NMBU-BuildingPhysics/SpatialSpectralMonitoring/04_Documentation/README.md

# Documentation

This folder contains project images and figures used in the main README and associated publication. Component-specific documentation is located alongside the code in each sub-folder.

## Images

| File | Description |
|---|---|
| `images/graphical_abstract.png` | Graphical abstract for the associated journal article |
| `images/Summary_image.png` | Conceptual overview of the sensing system capabilities |
| `images/NMBU_Logo_English_RGB.png` | NMBU institutional logo |

## Project Documentation

| Resource | Description |
|---|---|
| [Hardware Documentation](../01_Hardware/) | 3D models, PCB designs, and fabrication files |
| [Firmware Documentation](../02_Firmware/) | ESP32 code, utilities, and programming guides |
| [Python Suite Documentation](../03_Python_Suite/) | Analysis tools, calibration scripts, and validation |

## Contributing

Help improve this documentation by:

1. **Reporting Issues** - Found something unclear? Open an issue on GitHub
2. **Suggesting Improvements** - Have ideas for better organization or content?
3. **Contributing Content** - Write guides, fix typos, or add examples
