NMBU-BuildingPhysics/SpatialSpectralMonitoring/01_Hardware/PCB/Image_PCB.png

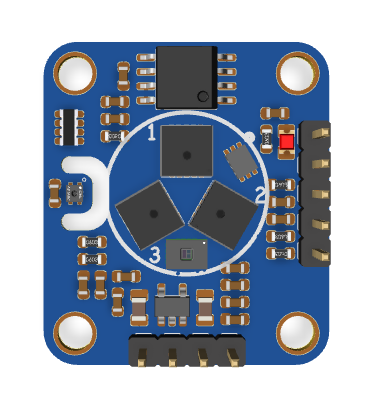
01_Hardware/PCB/Image_PCB.png
