NMBU-BuildingPhysics/SpatialSpectralMonitoring/03_Python_Suite/02_Absolute_Calibration/02_Spectral_Calibration/x1_Analysis_Plots/x1_spectral_sensor_response.png

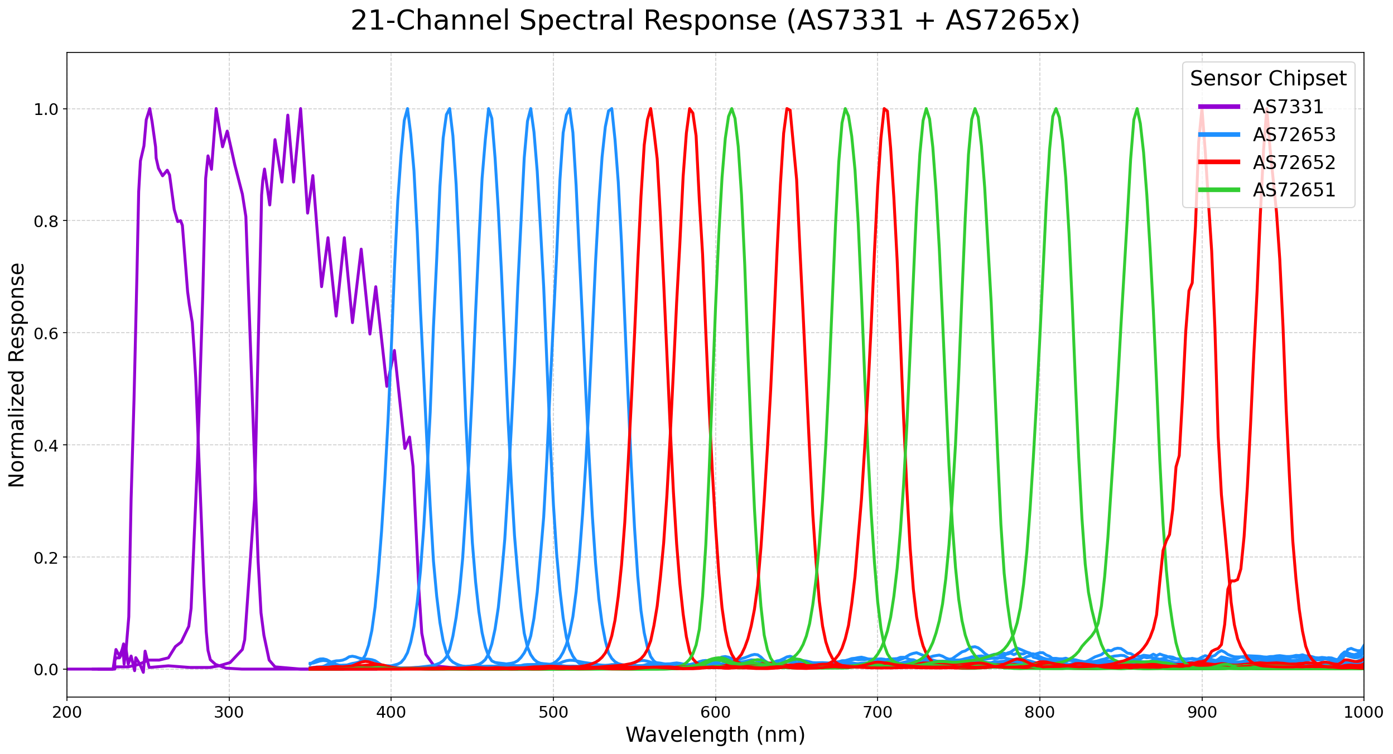
03_Python_Suite/02_Absolute_Calibration/02_Spectral_Calibration/x1_Analysis_Plots/x1_spectral_sensor_response.png
