NMBU-BuildingPhysics/SpatialSpectralMonitoring/01_Hardware/3d_Models/Source_Enclosure_Design.step

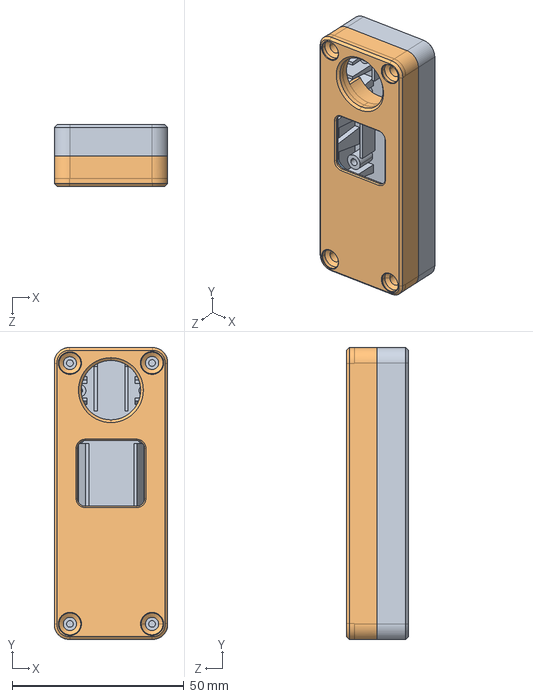
[picture p9: CAD file, 2026-10-23]
01_Hardware/3d_Models/Source_Enclosure_Design.step
33.0 x 85.0 x 18.0 mm
