NMBU-BuildingPhysics/SpatialSpectralMonitoring/01_Hardware/3d_Models/Enclosure_Print_Ready.stl

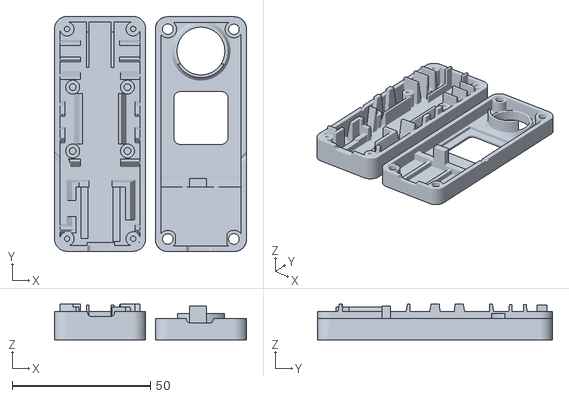
[picture p10: CAD file, 2026-02-18]
01_Hardware/3d_Models/Enclosure_Print_Ready.stl
69.5 x 85.1 x 12.9
