NMBU-BuildingPhysics/SpatialSpectralMonitoring/01_Hardware/3d_Models/Enclosure_Lid.stl

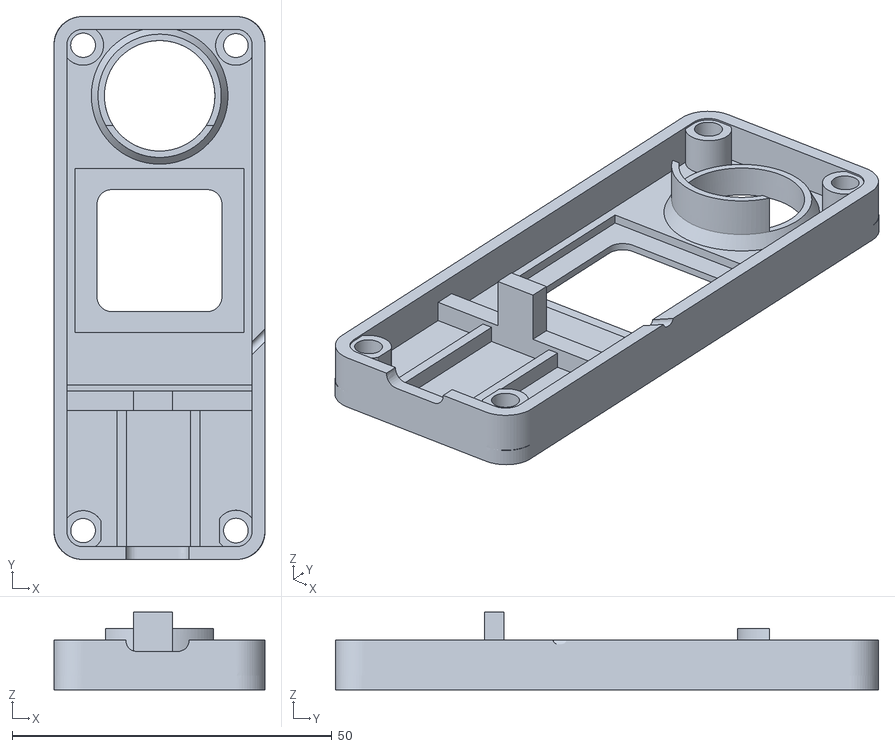
[picture p11: CAD file, 2026-02-18]
01_Hardware/3d_Models/Enclosure_Lid.stl
33.0 x 85.0 x 12.2
