NMBU-BuildingPhysics/SpatialSpectralMonitoring/(list of files, cad)

Other CAD files:
01_Hardware/3d_Models/Source_Enclosure_Design.3dm
