NMBU-BuildingPhysics/SpatialSpectralMonitoring/03_Python_Suite/02_Absolute_Calibration/01_Lux_Calibration/2_Results/calibration_results.txt

======================================================================
=== C++ LUX CALIBRATION FACTOR MAP ===
======================================================================
const std::map<std::string, float> universalLuxFactors = {
    {"sensor01", 5.19306f},
    {"sensor02", 4.96345f},
    {"sensor03", 5.12990f},
    {"sensor04", 4.46229f},
    {"sensor05", 5.38462f},
    {"sensor06", 5.20977f},
    {"sensor07", 5.30843f},
    {"sensor08", 5.21125f},
    {"sensor09", 5.18224f},
    {"sensor10", 5.16524f},
    {"sensor11", 4.98064f},
    {"sensor12", 5.06150f},
};
======================================================================
