NMBU-BuildingPhysics/SpatialSpectralMonitoring/03_Python_Suite/03_Validation/02_Narrowband_Validation/0_SPD_Reference/lightsource_narrowband_reference.csv

Light Source | 380nm | 381nm | 382nm | 383nm | 384nm | 385nm | 386nm | 387nm | 388nm | 389nm | 390nm | 391nm | 392nm | 393nm | 394nm | 395nm | 396nm | 397nm | 398nm | 399nm | 400nm | 401nm | 402nm | 403nm | 404nm | 405nm | 406nm | 407nm | 408nm | 409nm | 410nm | 411nm | 412nm | 413nm | 414nm | 415nm | 416nm | 417nm | 418nm | 419nm | 420nm | 421nm | 422nm | 423nm | 424nm | 425nm | 426nm | 427nm | 428nm | 429nm | 430nm | 431nm | 432nm | 433nm | 434nm | 435nm | 436nm | 437nm | 438nm
365 | 1 | 1 | 1 | 0.94814032139205 | 0.848396117652104 | 0.704984037896693 | 0.585327873321464 | 0.485452213029016 | 0.408468853283384 | 0.343960445787361 | 0.291926887572367 | 0.250003230639166 | 0.213220434464592 | 0.182543177342286 | 0.154822251091179 | 0.129879914782518 | 0.109048873572656 | 0.0913538777271807 | 0.0770642930487131 | 0.0658258046569702 | 0.0567996819918407 | 0.0500880183993867 | 0.04409799293131 | 0.0388295884261807 | 0.0342355251448154 | 0.0299970810124001 | 0.0260807054336159 | 0.0220883562049715 | 0.0179886450713069 | 0.0146284714333327 | 0.0124026168228726 | 0.0112656892580244 | 0.0100881920730566 | 0.00854917220727719 | 0.00679022861821847 | 0.00521000415941575 |
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
