NMBU-BuildingPhysics/SpatialSpectralMonitoring/03_Python_Suite/01_Characterization/02_Thermal_Analysis/1_a_Generate_temp_Coeffs/calibration_temp_coeffs_CPP.txt

// Automatically generated by 1_a_generate_temp_coeffs.py
// Copy and paste this into calibration.cpp

const std::map<std::string, TempCoeffSet> universalTempCoeffs = {
    {"CH1", {5.6359e-06f, 0.00151535f, 0.96201f}},
    {"CH10", {-1.65667e-06f, 0.000658259f, 0.98661f}},
    {"CH11", {-5.60397e-06f, 0.000334511f, 0.997199f}},
    {"CH12", {3.76807e-06f, 0.000848555f, 0.979243f}},
    {"CH13", {-4.08386e-06f, 0.00045463f, 0.994575f}},
    {"CH14", {-2.44684e-06f, 0.00057235f, 0.990061f}},
    {"CH15", {-4.51939e-06f, 0.0013828f, 0.970007f}},
    {"CH16", {3.43816e-06f, 0.00145683f, 0.9643f}},
    {"CH17", {4.38768e-06f, 0.0016077f, 0.957907f}},
    {"CH18", {1.33183e-05f, 0.00198303f, 0.943949f}},
    {"CH2", {-7.7512e-07f, 0.00128163f, 0.971924f}},
    {"CH3", {4.33132e-06f, 0.00147816f, 0.962583f}},
    {"CH4", {-1.62839e-06f, 0.00101142f, 0.979043f}},
    {"CH5", {-1.17734e-06f, 0.000944586f, 0.979559f}},
    {"CH6", {4.9695e-07f, 0.000739002f, 0.984583f}},
    {"CH7", {-3.85825e-06f, 0.00071504f, 0.987782f}},
    {"CH8", {2.45204e-06f, 0.00105256f, 0.975107f}},
    {"CH9", {-9.22882e-06f, 0.000201256f, 1.00387f}},
    {"LUX", {2.97295e-06f, 0.00293187f, 0.927646f}},
    {"UVA", {-9.54924e-06f, 0.000301947f, 1.00142f}},
    {"UVB", {-6.96075e-06f, 0.00107086f, 0.979895f}},
    {"UVC", {-5.81022e-06f, 0.0013241f, 0.972291f}},
};
