NMBU-BuildingPhysics/SpatialSpectralMonitoring/03_Python_Suite/02_Absolute_Calibration/02_Spectral_Calibration/0_SPD_Reference/SPD_sun2000_Simulator.csv

Wavelength | Irradiance
301.4 | 0.0126412608076059
302.6 | 0.0141957427198981
303.9 | 0.0157720714570111
305.1 | 0.0175633294009393
306.4 | 0.0209620909724188
307.7 | 0.0255545839671508
309 | 0.0301200621318826
310.3 | 0.0379568996994468
311.6 | 0.0456715689764131
312.9 | 0.0555255897539688
314.2 | 0.0663688778043907
315.6 | 0.0818582446858823
316.9 | 0.101266510233139
318.3 | 0.120120442306183
319.6 | 0.144106679852594
321 | 0.174182853023603
322.4 | 0.205394579702321
323.8 | 0.235525396970662
325.2 | 0.270605381904598
326.6 | 0.306485934581814
328 | 0.337254845315079
329.4 | 0.375440535732994
330.9 | 0.407180675696389
332.3 | 0.440404400482819
333.7 | 0.47432452262772
335.2 | 0.492623775045391
336.6 | 0.522184205127701
338.1 | 0.549038289238331
339.5 | 0.561877837662456
341 | 0.581652315532127
342.5 | 0.606567038629839
343.9 | 0.623833766438226
345.4 | 0.635385457072685
346.9 | 0.646428431158822
348.4 | 0.653037690228921
349.9 | 0.661378567938397
351.4 | 0.669544996635771
352.9 | 0.683185875899641
354.4 | 0.692941644677875
355.9 | 0.710518554563627
357.4 | 0.726263682805619
358.9 | 0.744585027653116
360.4 | 0.763763223699122
361.9 | 0.778963046220284
363.4 | 0.798711453407329
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
