NMBU-BuildingPhysics/SpatialSpectralMonitoring/03_Python_Suite/03_Validation/01_Spectral_Validation/0_SPD_Reference/AS7265x/SPD_AS7265x.csv

Wavelength | ch1 | ch2 | ch3 | ch4 | ch5 | ch6 | ch7 | ch8 | ch9 | ch10 | ch11 | ch12 | ch13 | ch14 | ch15 | ch16 | ch17 | ch18
350 | 0.00886187261830576 | 0.00275384914017557 | 0.0103733082114949 | 0.000858220142784128 | 0.00164435722017183 | 0.000786519361784536 | 3.95299972870521E-05 | 0.000172213468865133 | 0.000152397346431933 | 0.000251704026298732 | 0.000097072477475942 | 0.0001103083775882 | 0.000731783179141658 | 0.00183028497691882 | 0.000576912862685917 | 0.000400711303247616 | 0 | 0
351 | 0.0108806939906741 | 0.00274202890438531 | 0.0106008443729033 | 0.00117147045959339 | 0.00220727941667201 | 0.000813850176651507 | 3.95299972870521E-05 | 0.000192402714090236 | 0.000232174510223655 | 0.000304889206639144 | 0.000133939773089225 | 0.00013248362268091 | 0.000922275589270478 | 0.00223674164938589 | 0.000744773094391813 | 0.000524011637019787 | 0 | 0
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
