NMBU-BuildingPhysics/SpatialSpectralMonitoring/03_Python_Suite/03_Validation/02_Narrowband_Validation/0_SPD_Reference/AS7331/SPD_AS7331_uvc.csv

Wavelength | uvc
200.71856287425152 | 0
229.46107784431138 | 0
229.46107784431138 | 13.698630136986367
230.1796407185629 | 18.264840182648413
231.61676646706587 | 18.264840182648413
232.33532934131736 | 18.264840182648413
233.05389221556885 | 21.308980213089853
234.85029940119762 | 41.09589041095887
235.92814371257487 | 16.742770167427807
238.08383233532936 | 85.23592085235919
239.52095808383234 | 277.0167427701674
241.3173652694611 | 439.8782343987823
243.11377245508982 | 642.3135464231354
244.19161676646706 | 777.7777777777777
245.2694610778443 | 828.0060882800608
247.4251497005988 | 852.3592085235921
248.8622754491018 | 894.9771689497716
251.01796407185628 | 913.24200913242
252.45508982035926 | 891.9330289193302
254.61077844311376 | 850.8371385083713
254.97005988023955 | 832.572298325723
256.4071856287425 | 815.8295281582953
258.92215568862275 | 803.6529680365296
261.7964071856287 | 812.7853881278538
263.23353293413174 | 805.1750380517503
266.1077844311377 | 748.8584474885845
268.2634730538922 | 729.0715372907152
270.0598802395209 | 730.5936073059361
271.13772455089816 | 722.9832572298325
273.29341317365265 | 651.4459665144595
274.3712574850299 | 614.9162861491629
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
