NMBU-BuildingPhysics/SpatialSpectralMonitoring/03_Python_Suite/01_Characterization/02_Thermal_Analysis/2_a_Grid_Plots/temperature_correction_grid_deg2.png

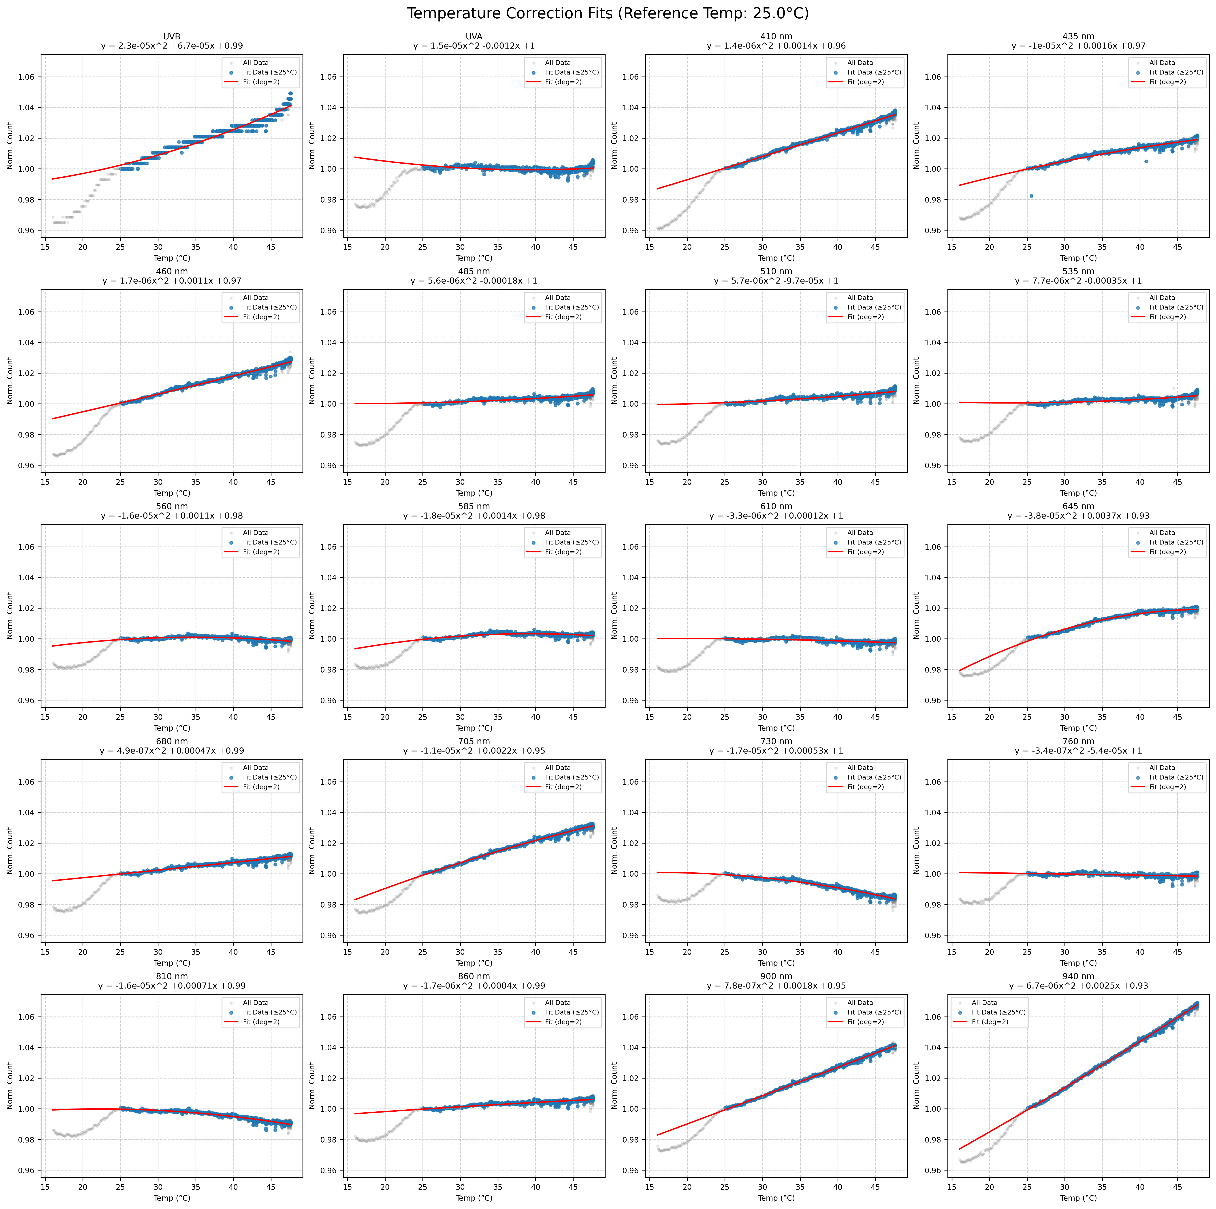
03_Python_Suite/01_Characterization/02_Thermal_Analysis/2_a_Grid_Plots/temperature_correction_grid_deg2.png
