NMBU-BuildingPhysics/SpatialSpectralMonitoring/03_Python_Suite/01_Characterization/02_Thermal_Analysis/2_b_Analysis_Plots/temperature_sensitivity_barchart.png

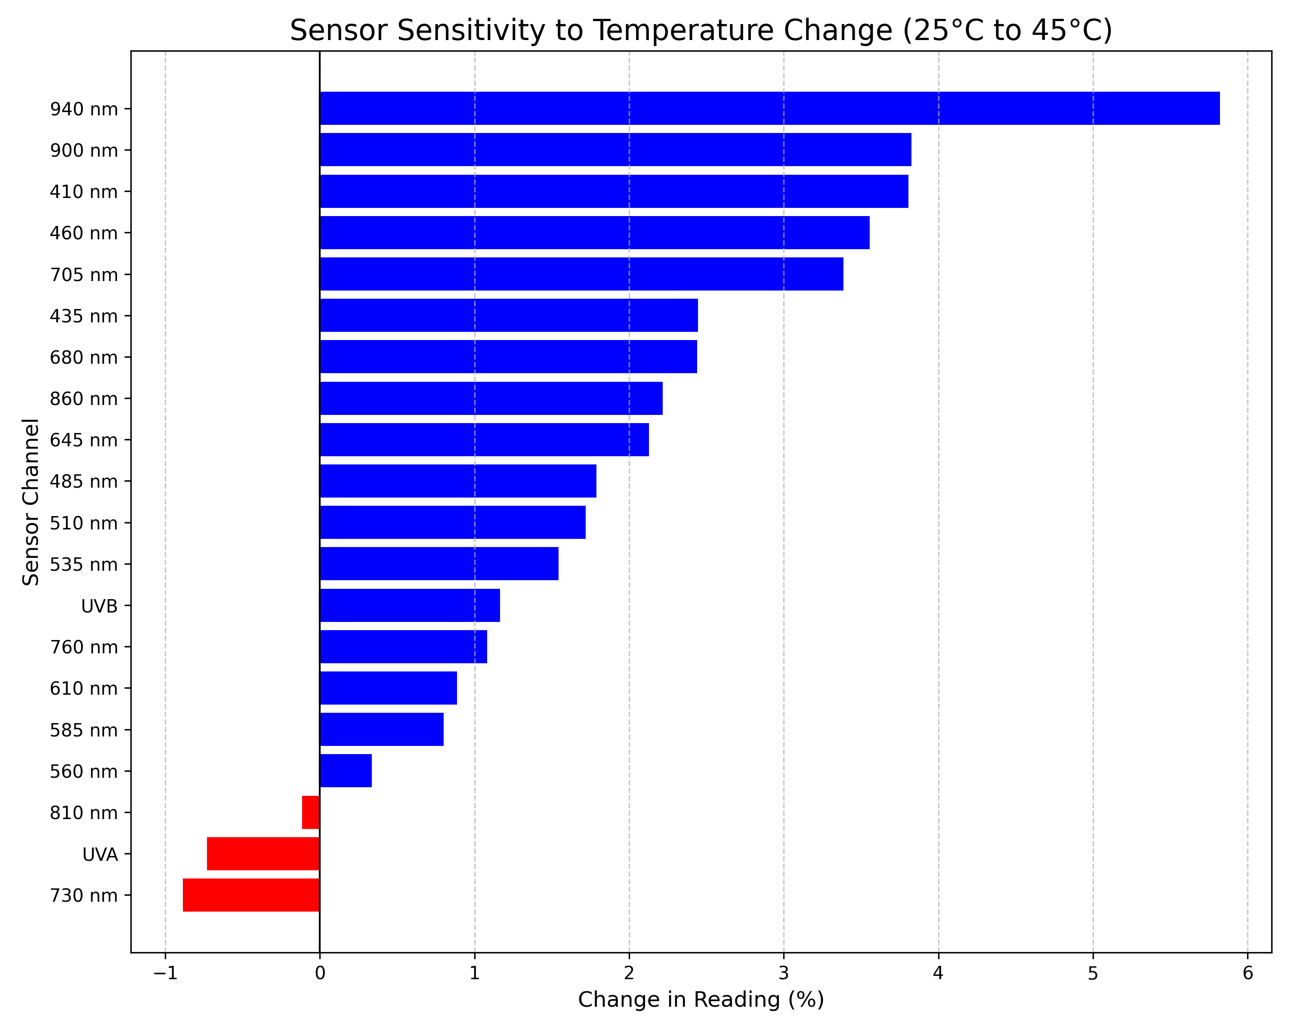
03_Python_Suite/01_Characterization/02_Thermal_Analysis/2_b_Analysis_Plots/temperature_sensitivity_barchart.png
