NMBU-BuildingPhysics/SpatialSpectralMonitoring/03_Python_Suite/01_Characterization/03_Cosine_Correction/01_cosine_correction_average/01_cosine_correction_average.png

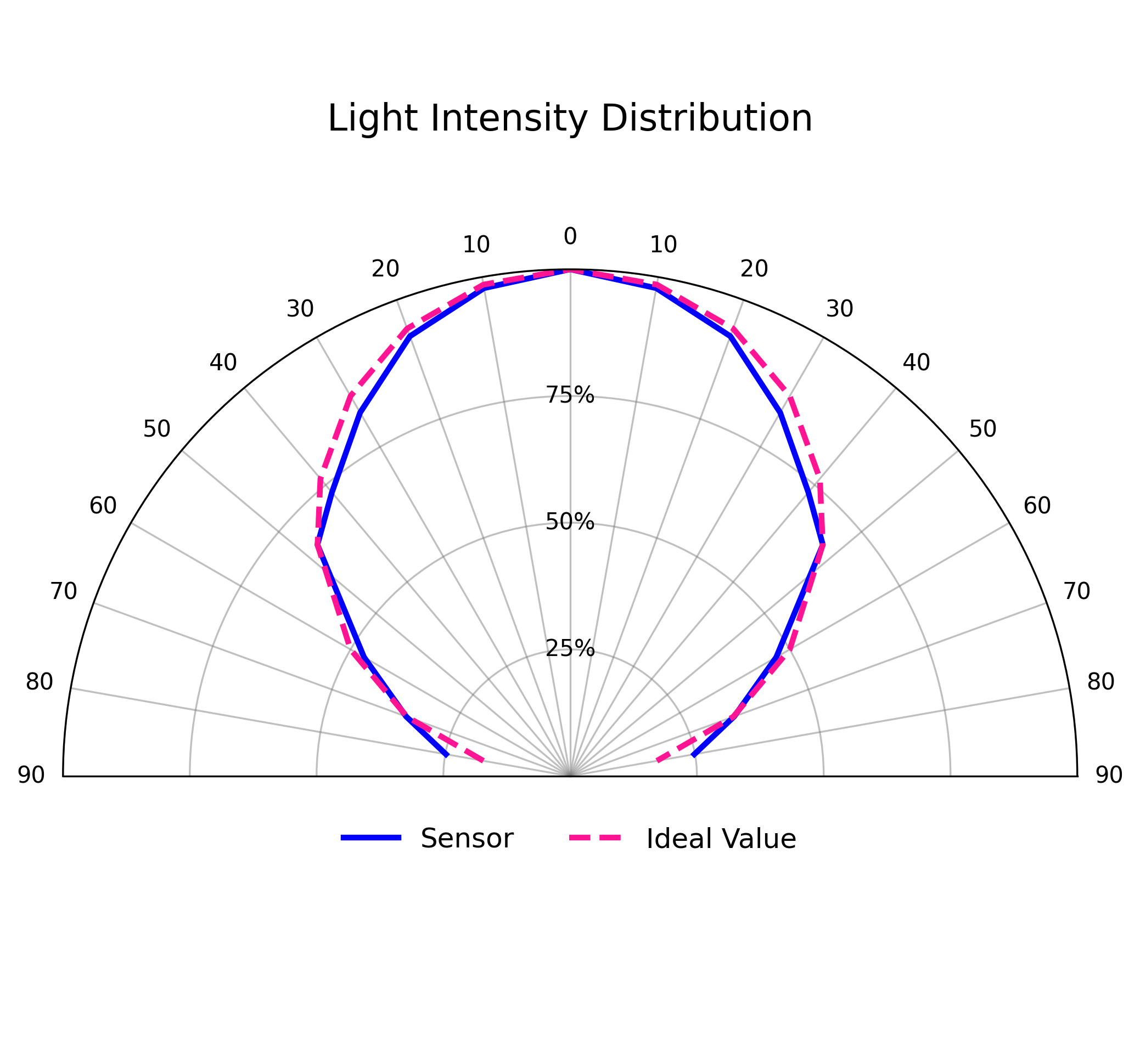
03_Python_Suite/01_Characterization/03_Cosine_Correction/01_cosine_correction_average/01_cosine_correction_average.png
