NMBU-BuildingPhysics/SpatialSpectralMonitoring/03_Python_Suite/01_Characterization/03_Cosine_Correction/02_cosine_correction_all_wavelengths/02_cosine_correction_all_wavelengths.png

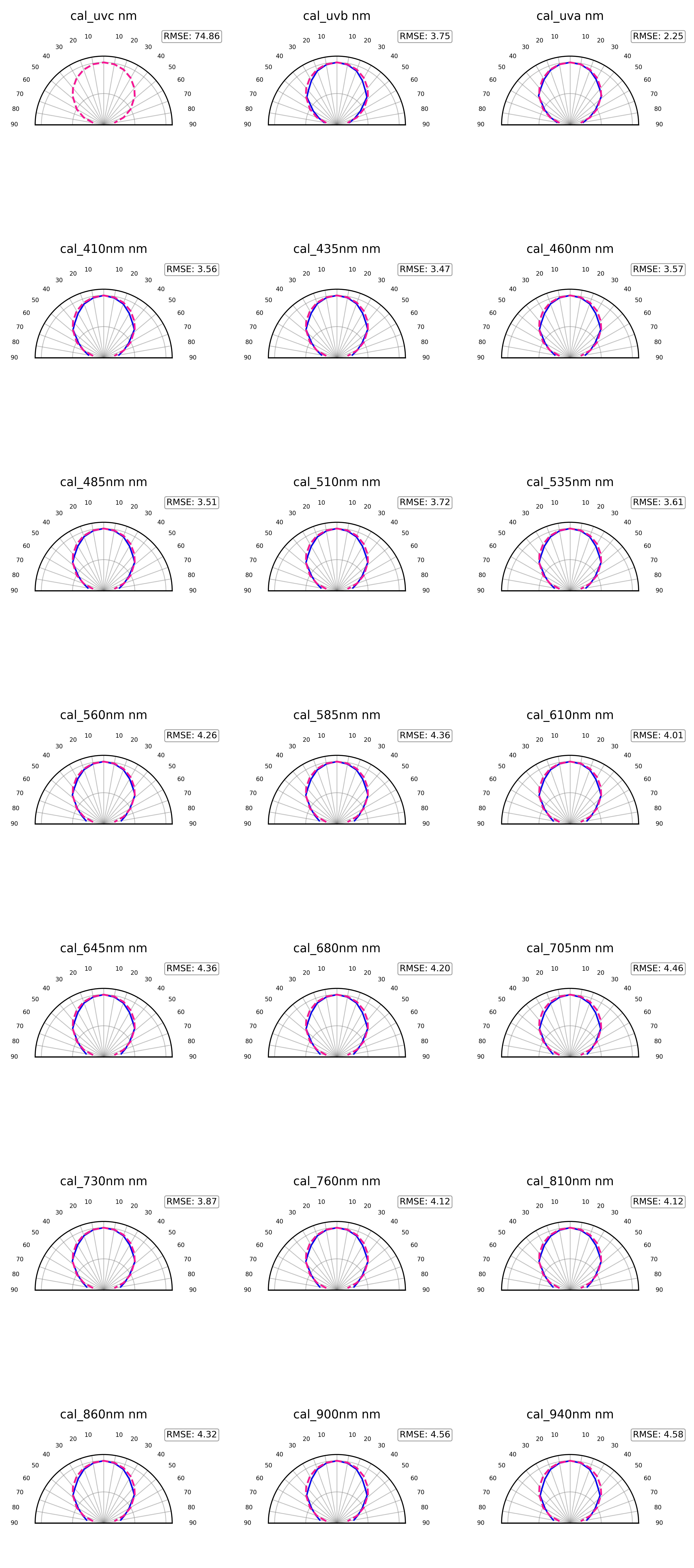
03_Python_Suite/01_Characterization/03_Cosine_Correction/02_cosine_correction_all_wavelengths/02_cosine_correction_all_wavelengths.png
