NMBU-BuildingPhysics/SpatialSpectralMonitoring/03_Python_Suite/01_Characterization/04_Camera_Characterization/05_correct_vignetting_output/sensor04_vignetting_plot.png

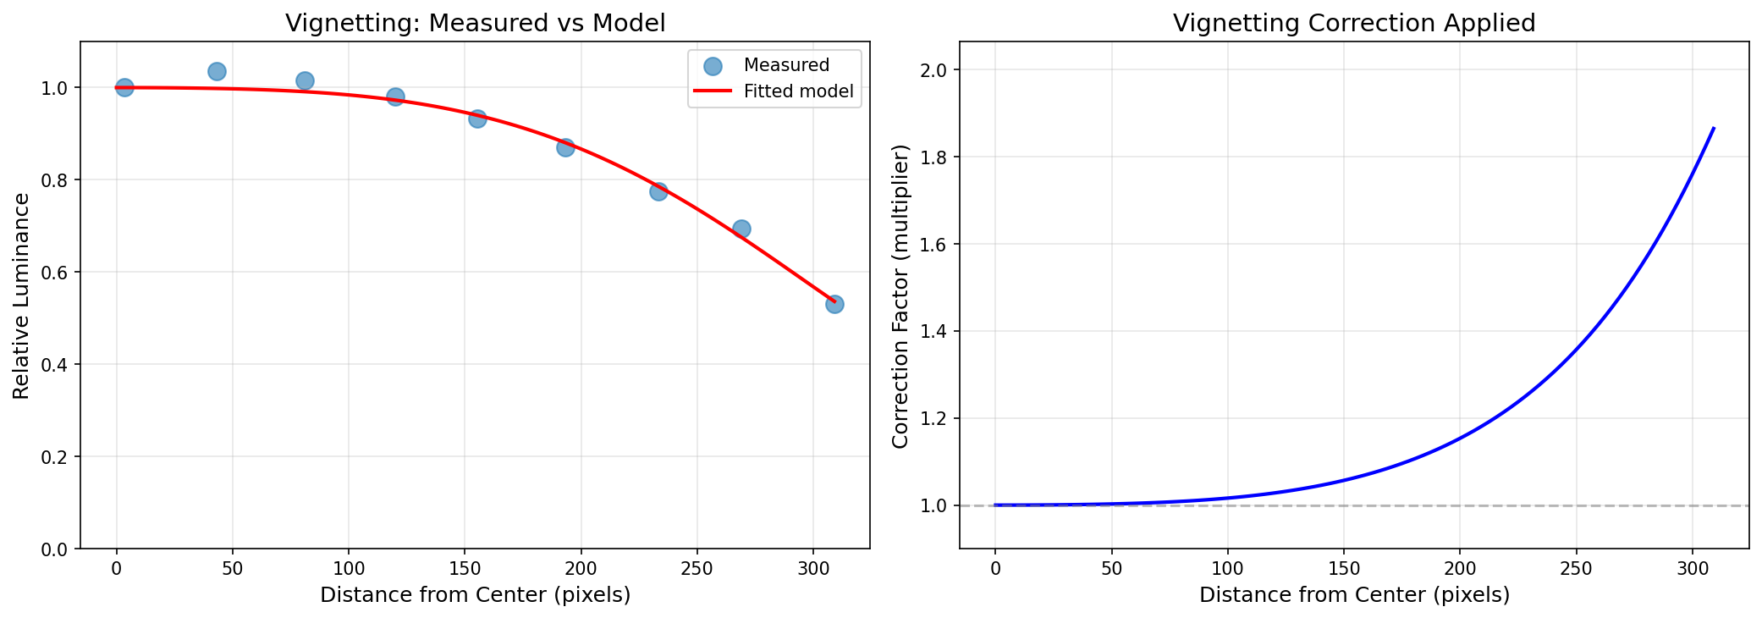
03_Python_Suite/01_Characterization/04_Camera_Characterization/05_correct_vignetting_output/sensor04_vignetting_plot.png
