NMBU-BuildingPhysics/SpatialSpectralMonitoring/03_Python_Suite/02_Absolute_Calibration/01_Lux_Calibration/1_temp_coeffs/lux_temp_correction_plot.png

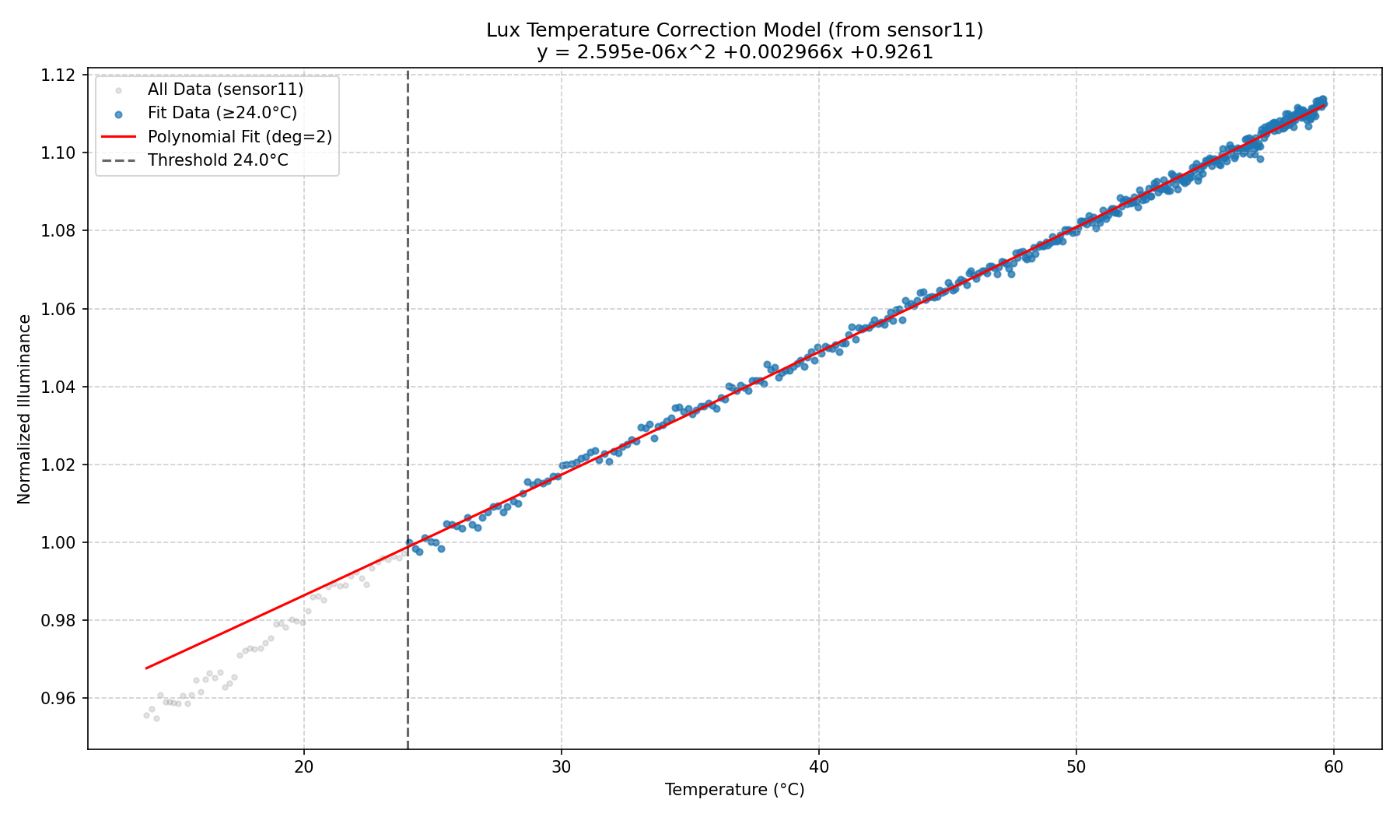
03_Python_Suite/02_Absolute_Calibration/01_Lux_Calibration/1_temp_coeffs/lux_temp_correction_plot.png
