NMBU-BuildingPhysics/SpatialSpectralMonitoring/03_Python_Suite/02_Absolute_Calibration/02_Spectral_Calibration/1_Analysis_plots/A6_SPD_simulator_vs_nano.png

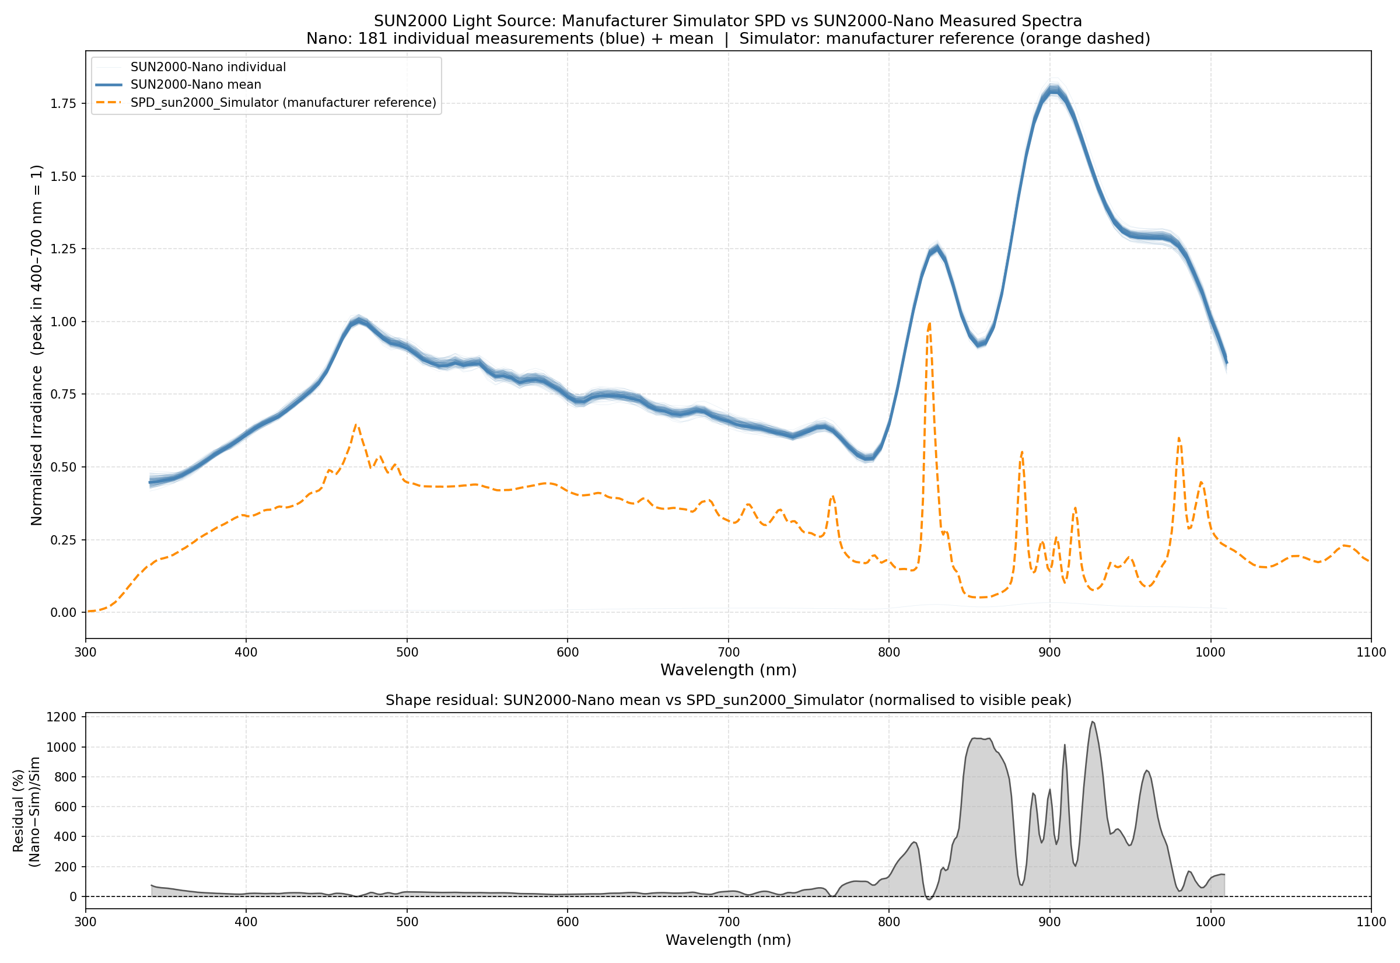
03_Python_Suite/02_Absolute_Calibration/02_Spectral_Calibration/1_Analysis_plots/A6_SPD_simulator_vs_nano.png
