NMBU-BuildingPhysics/SpatialSpectralMonitoring/03_Python_Suite/02_Absolute_Calibration/02_Spectral_Calibration/1_Analysis_plots/calibration_coefficients_VIS_NIR.png

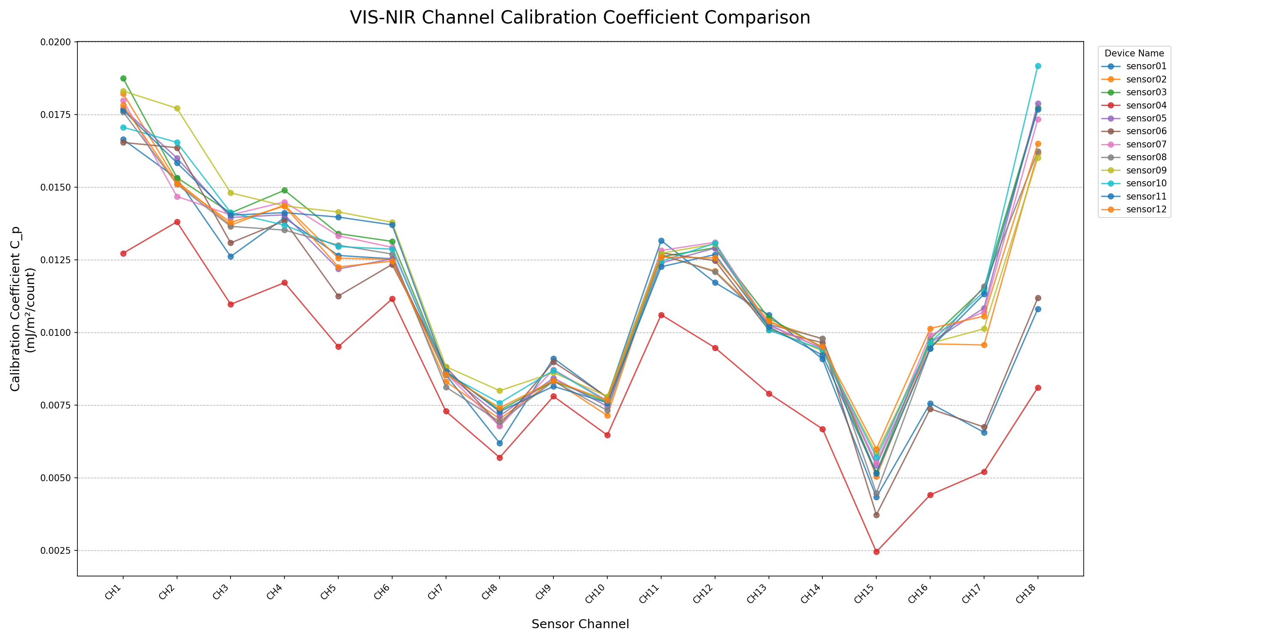
03_Python_Suite/02_Absolute_Calibration/02_Spectral_Calibration/1_Analysis_plots/calibration_coefficients_VIS_NIR.png
