NMBU-BuildingPhysics/SpatialSpectralMonitoring/03_Python_Suite/02_Absolute_Calibration/02_Spectral_Calibration/x2_Analysis_Plots/x2_spd_visualization_with_source.png

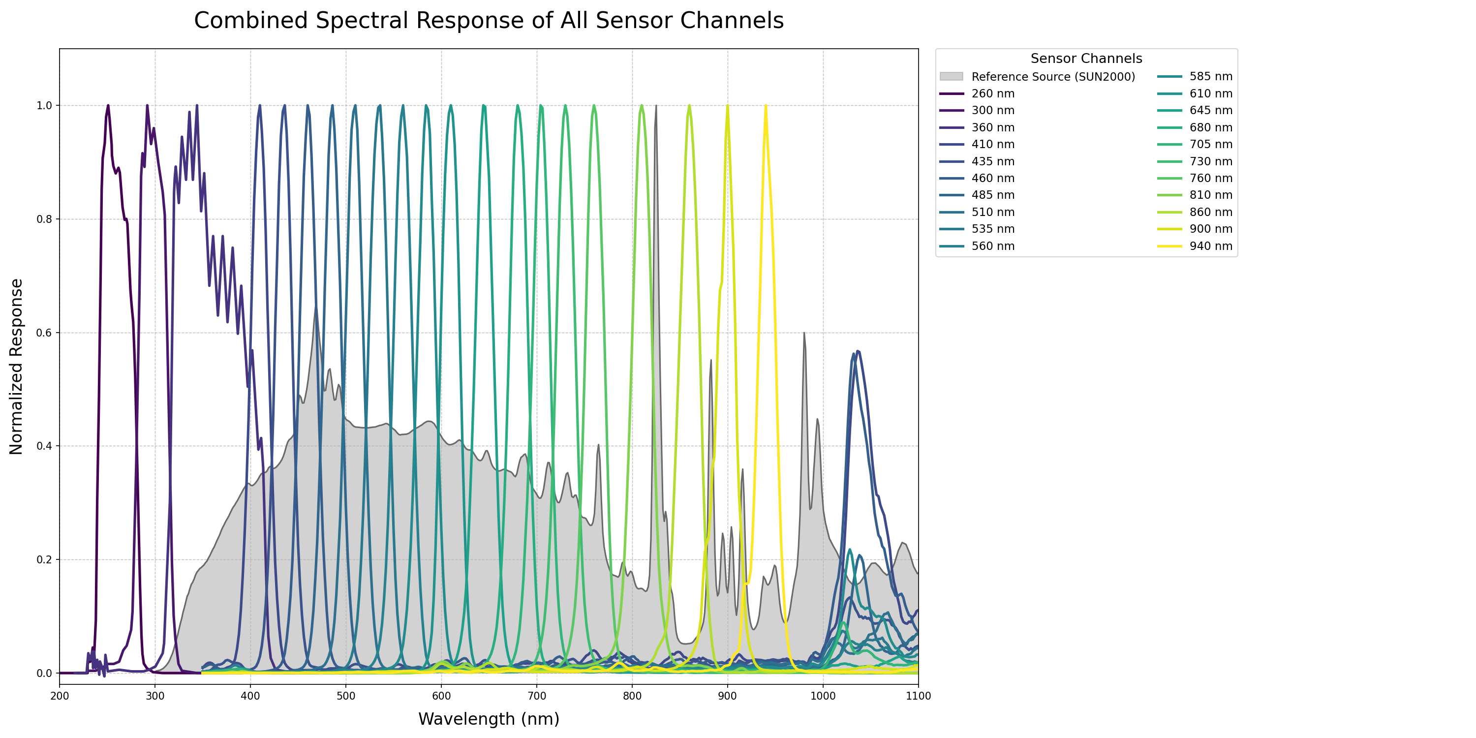
03_Python_Suite/02_Absolute_Calibration/02_Spectral_Calibration/x2_Analysis_Plots/x2_spd_visualization_with_source.png
