NMBU-BuildingPhysics/SpatialSpectralMonitoring/03_Python_Suite/02_Absolute_Calibration/03_Camera_Calibration/02_validate_output/sensor02_falsecolor.png

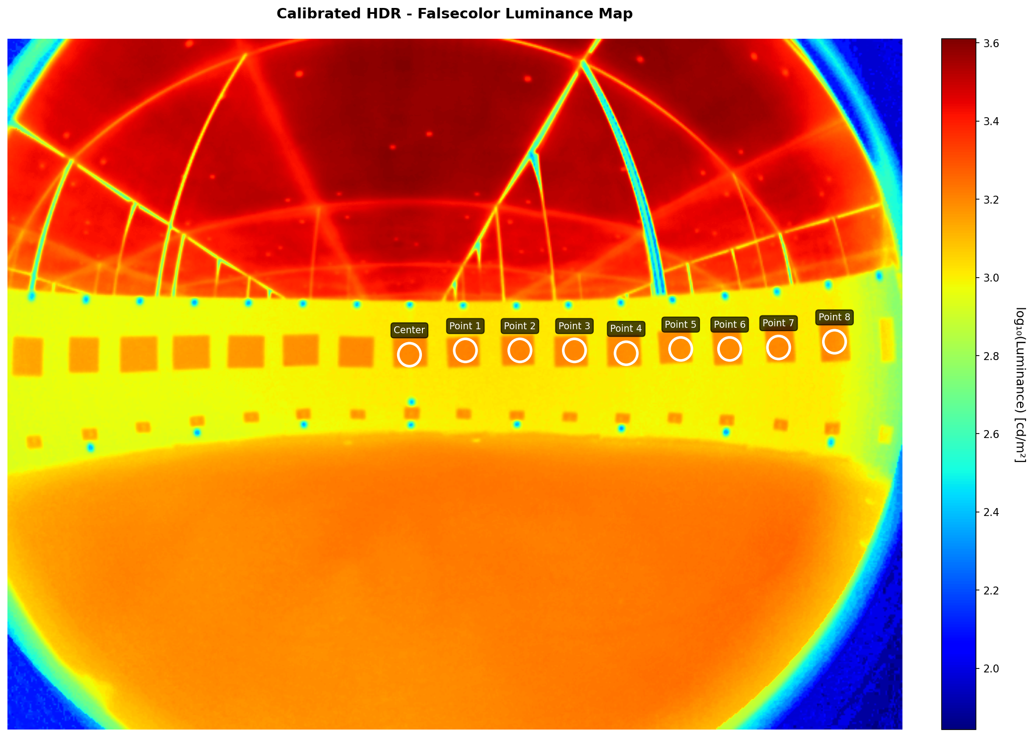
03_Python_Suite/02_Absolute_Calibration/03_Camera_Calibration/02_validate_output/sensor02_falsecolor.png
