NMBU-BuildingPhysics/SpatialSpectralMonitoring/03_Python_Suite/03_Validation/01_Spectral_Validation/2_Analysis_plots/validation_summary.png

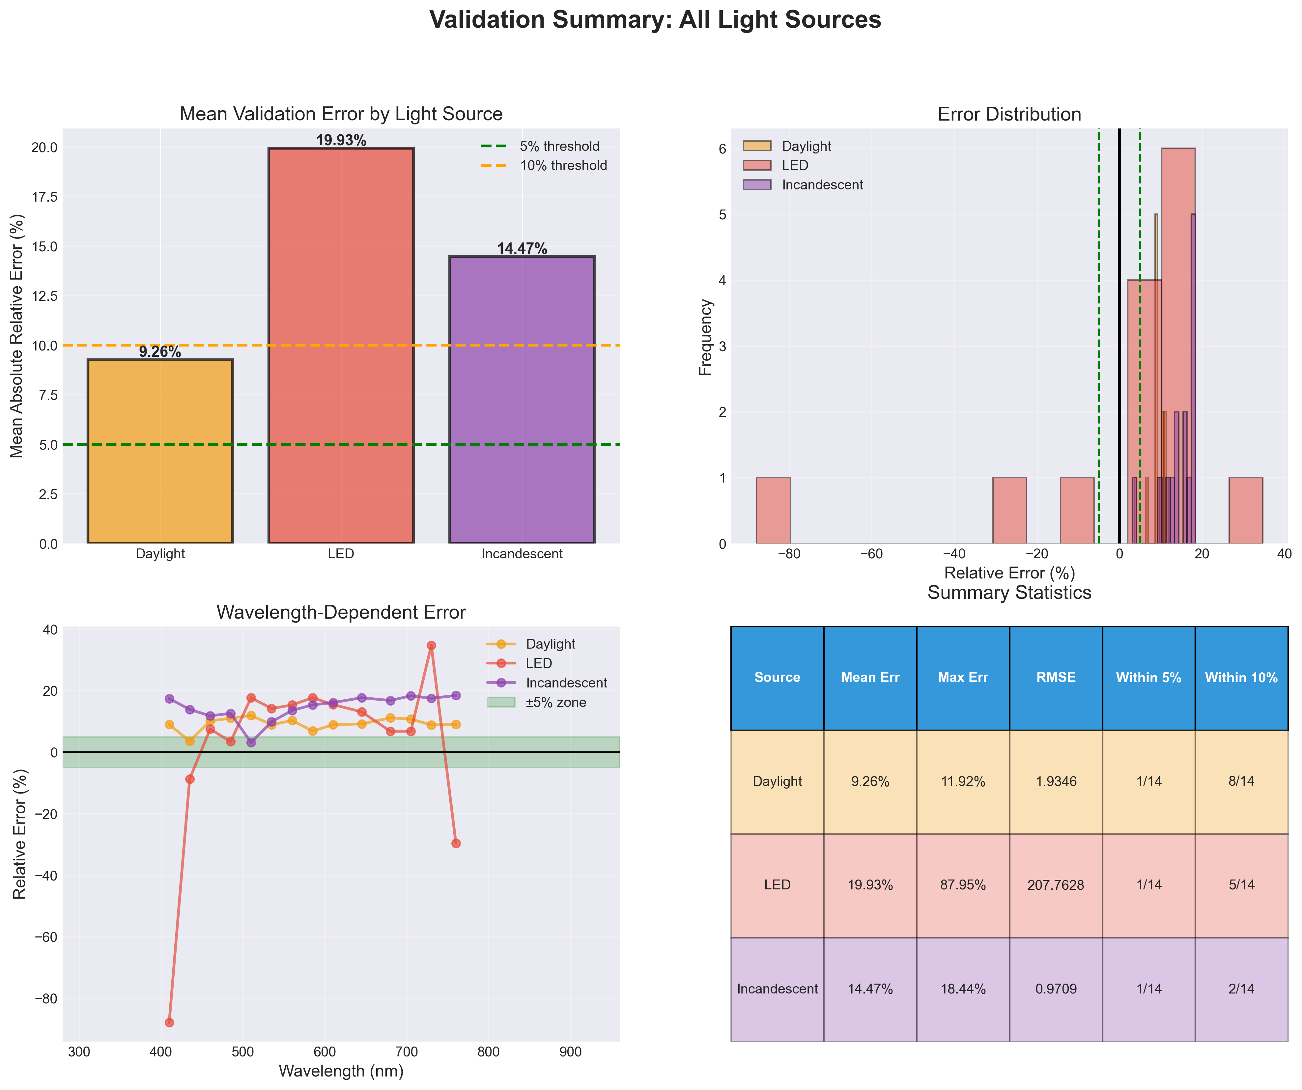
03_Python_Suite/03_Validation/01_Spectral_Validation/2_Analysis_plots/validation_summary.png
