NMBU-BuildingPhysics/SpatialSpectralMonitoring/03_Python_Suite/03_Validation/02_Narrowband_Validation/1_Analysis_plots/summary_plot_1_signal_purity.png

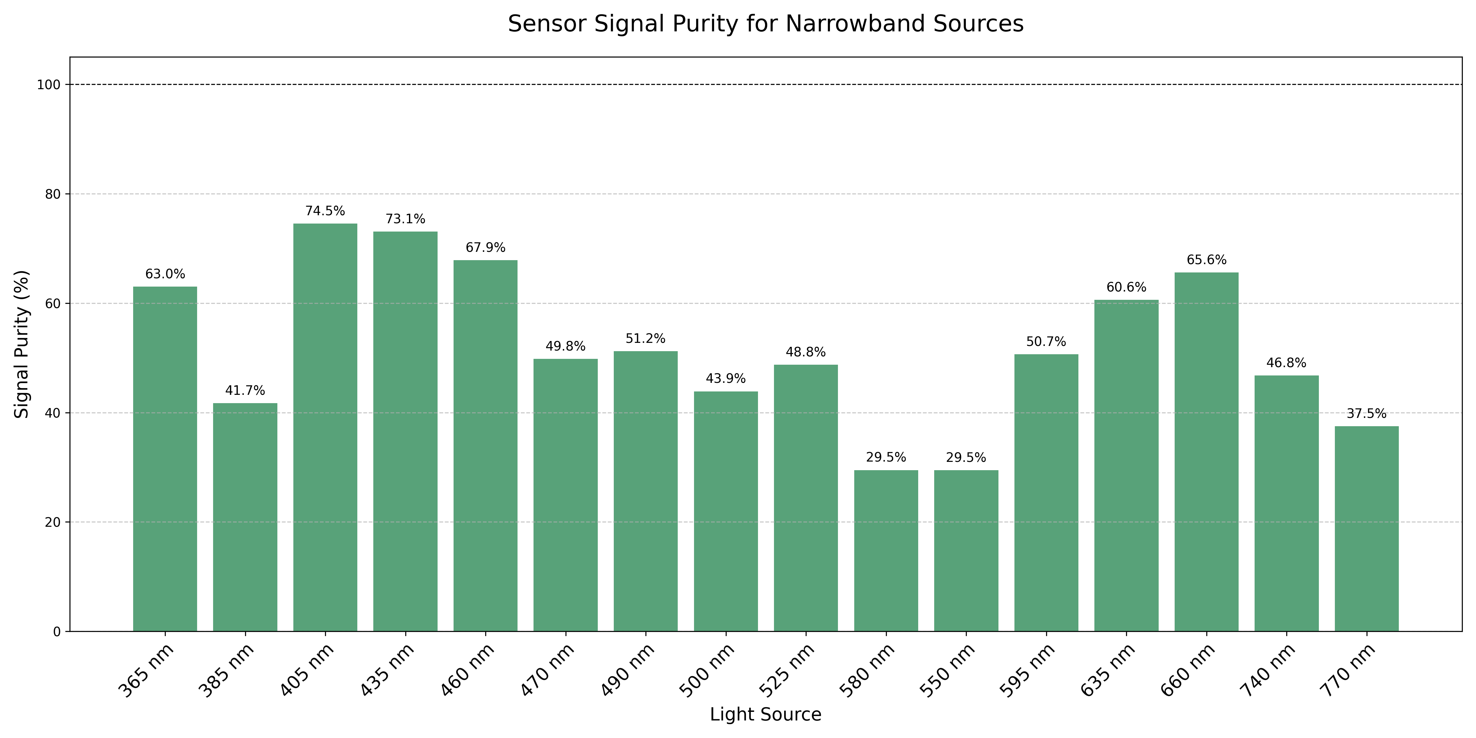
03_Python_Suite/03_Validation/02_Narrowband_Validation/1_Analysis_plots/summary_plot_1_signal_purity.png
