NMBU-BuildingPhysics/SpatialSpectralMonitoring/03_Python_Suite/03_Validation/02_Narrowband_Validation/1_Analysis_plots/summary_plot_3_all_in_one_grid_zoomed.png

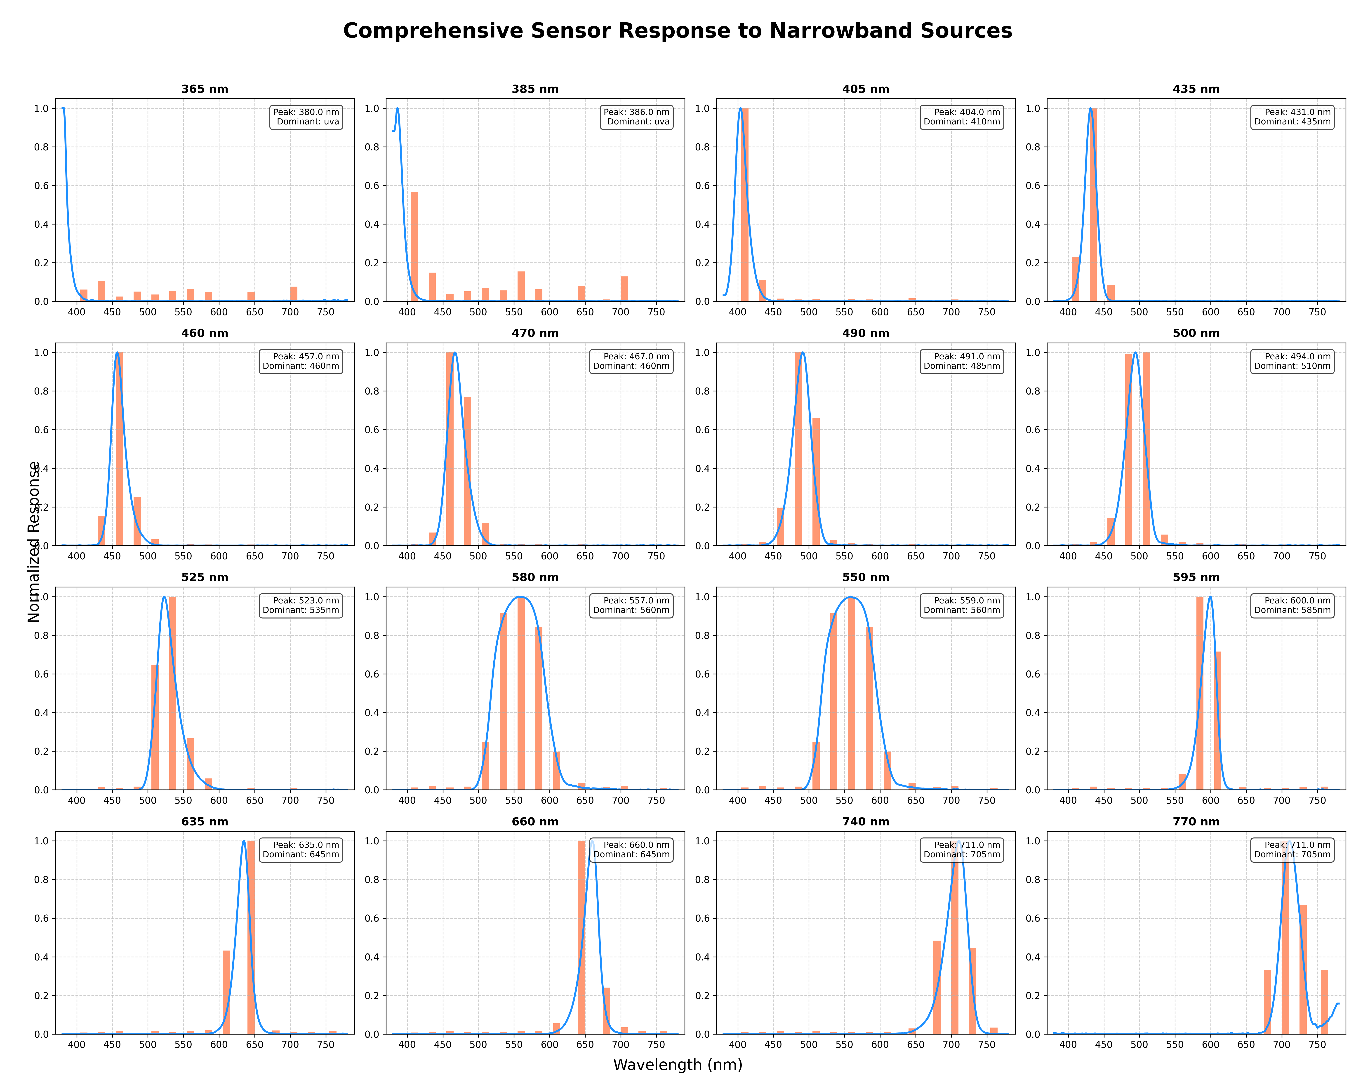
03_Python_Suite/03_Validation/02_Narrowband_Validation/1_Analysis_plots/summary_plot_3_all_in_one_grid_zoomed.png
