NMBU-BuildingPhysics/SpatialSpectralMonitoring/03_Python_Suite/03_Validation/02_Narrowband_Validation/1_Analysis_plots/validation_plots_Individual/individual_validation_405_.png

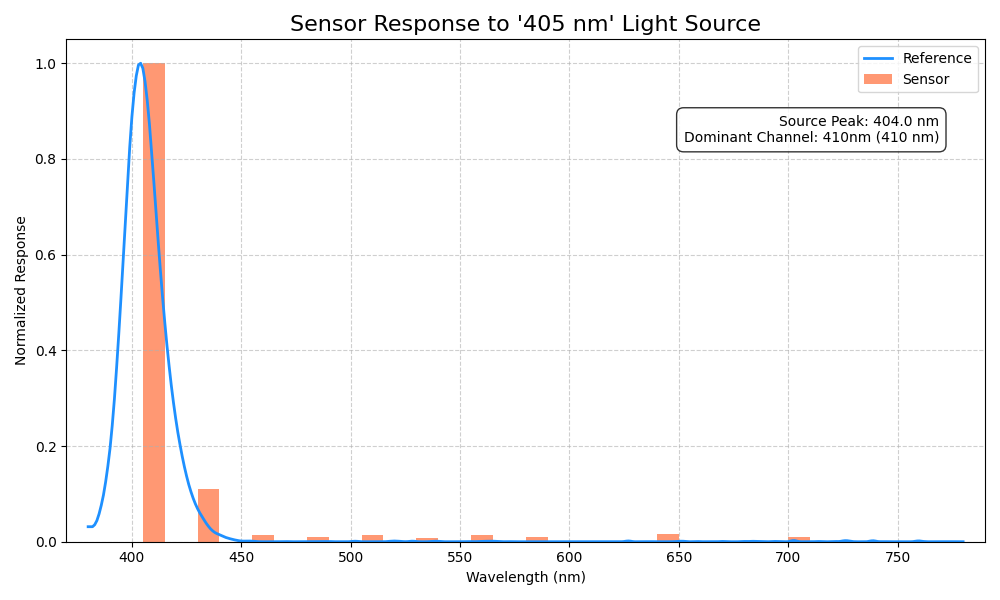
03_Python_Suite/03_Validation/02_Narrowband_Validation/1_Analysis_plots/validation_plots_Individual/individual_validation_405_.png
