NMBU-BuildingPhysics/SpatialSpectralMonitoring/01_Hardware/PCB/Dimensions.pdf

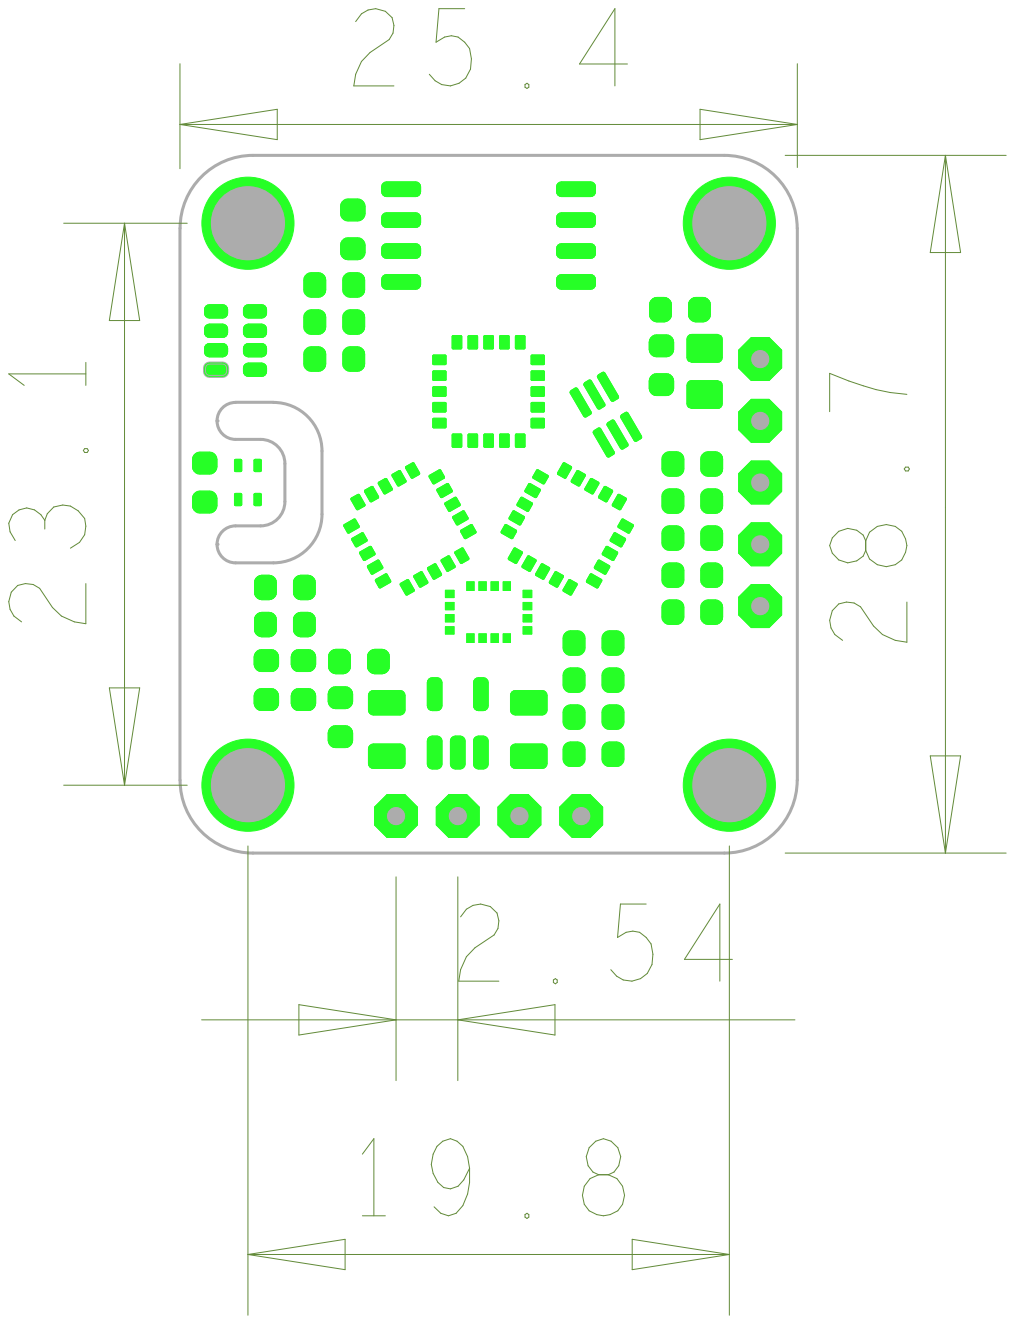
[picture p57: page 1]

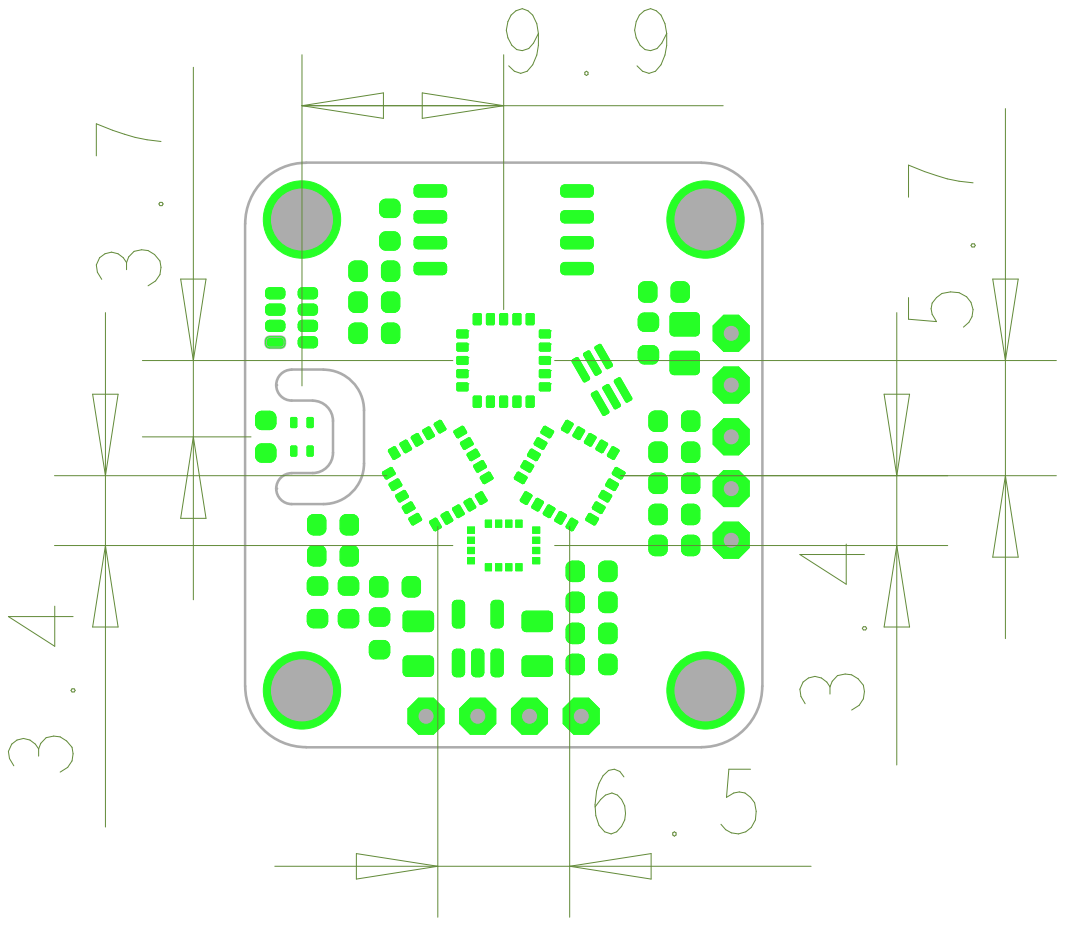
[picture p58: page 2]

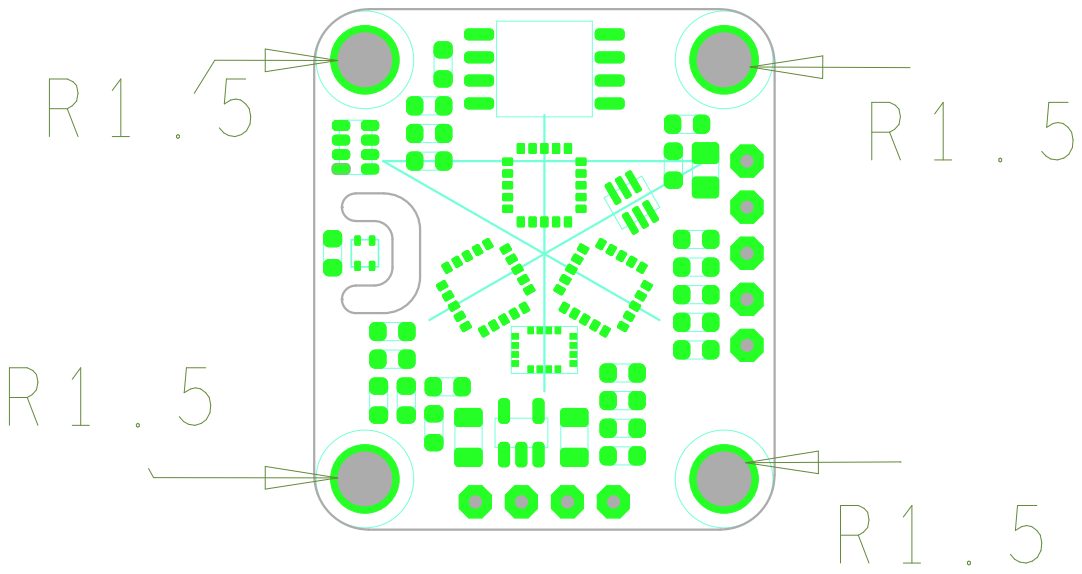
[picture p59: page 3]
