NMBU-BuildingPhysics/SpatialSpectralMonitoring/01_Hardware/PCB/Schematics.pdf

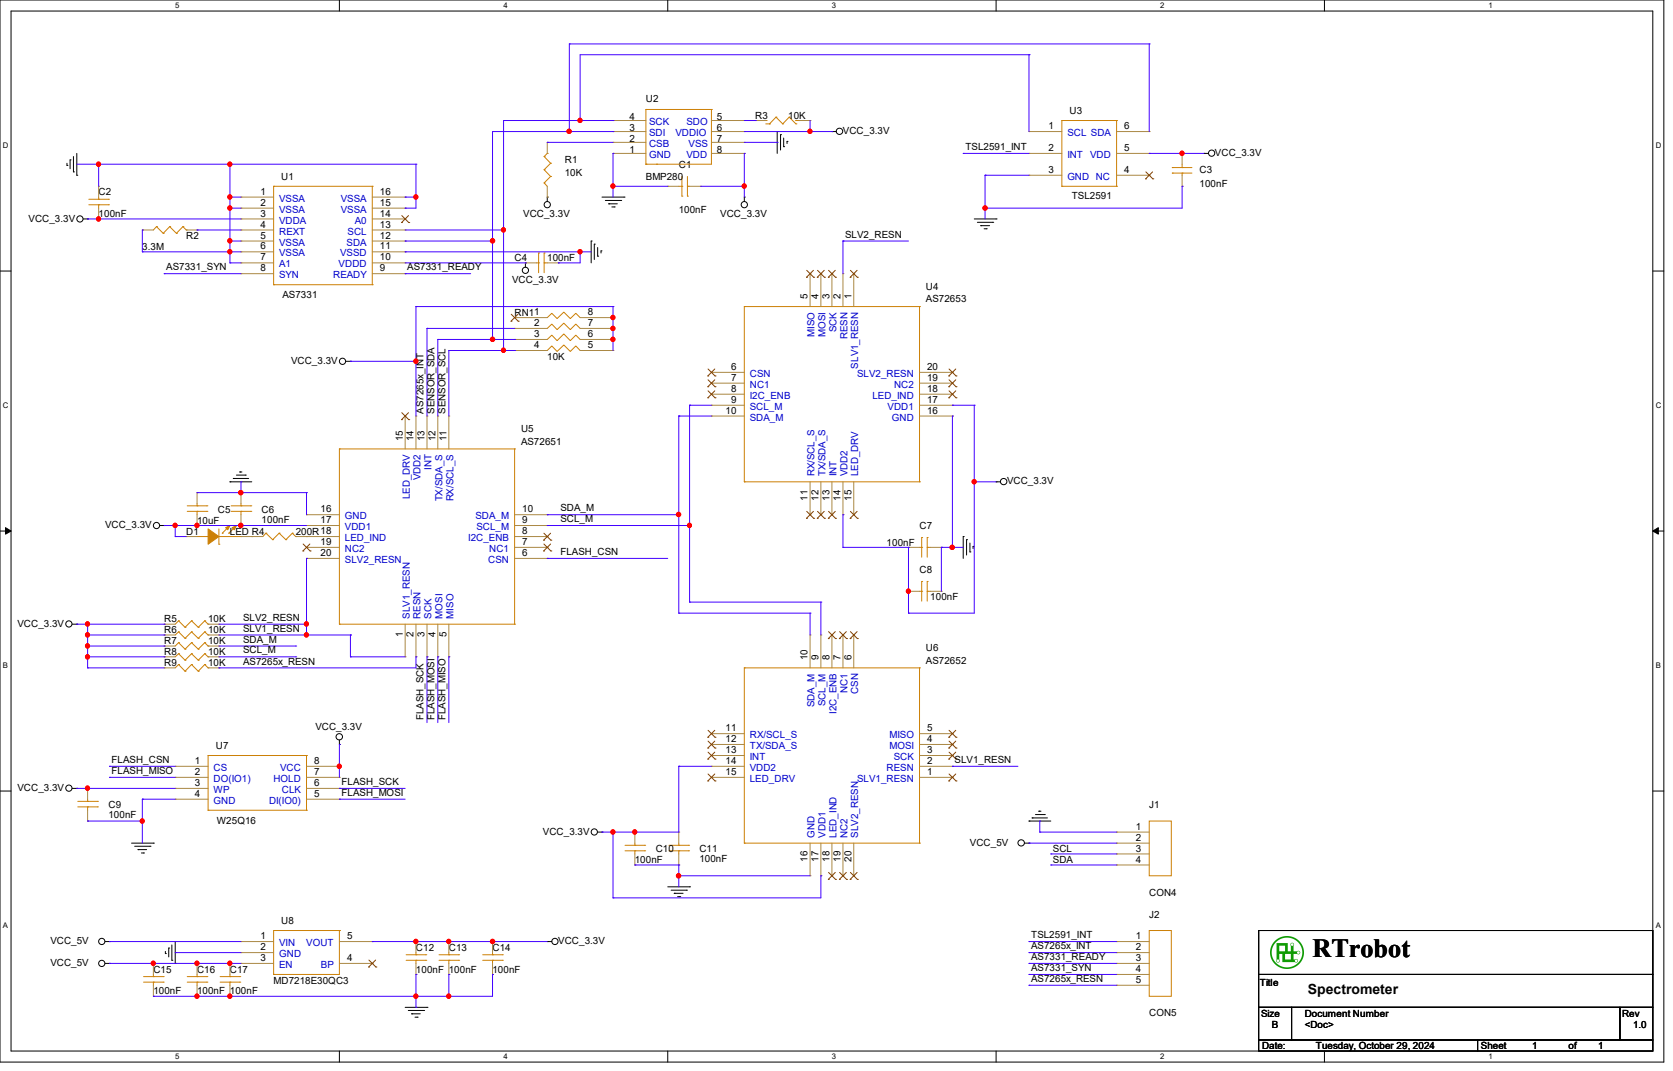
[picture p60: page 1]

SLV1_RESN 1 SLV2_RESN 20 RESN 2 SCK 3 MOSI 4 MISO 5

3 6
4 5
