NMBU-BuildingPhysics/SpatialSpectralMonitoring/02_Firmware/Main/sensors.cpp

/*
* Project: Spatial-Spectral Sensing System
* Paper:   Enabling scalable, human-centric daylight assessment: A validated open-source sensing system for spatial-spectral monitoring in buildings
* Author:  Tobias Kristiansen / NMBU Building Physics
* License: GNU General Public License v3.0
*
* Description:
* This directory contains the source code for the ESP32-S3 microcontroller
* This file contains sensor initialization and reading functions  
*/

#include "sensors.h"
#include "functions.h"
#include "globals.h" 

#define CAMERA_MODEL_XIAO_ESP32S3
#include "src/sensors/camera_pins.h"

TSL2591 tsl;
SHT4X sht;
AS7265X as7265x;
AS7331 as7331;

// --------------- INITIALIZATION -------------

void setupOV5640_jpeg() {
  camera_config_t config;
  config.ledc_channel = LEDC_CHANNEL_0;
  config.ledc_timer = LEDC_TIMER_0;
  config.pin_d0 = Y2_GPIO_NUM;
  config.pin_d1 = Y3_GPIO_NUM;
  config.pin_d2 = Y4_GPIO_NUM;
  config.pin_d3 = Y5_GPIO_NUM;
  config.pin_d4 = Y6_GPIO_NUM;
  config.pin_d5 = Y7_GPIO_NUM;
  config.pin_d6 = Y8_GPIO_NUM;
  config.pin_d7 = Y9_GPIO_NUM;
  config.pin_xclk = XCLK_GPIO_NUM;
  config.pin_pclk = PCLK_GPIO_NUM;
  config.pin_vsync = VSYNC_GPIO_NUM;
  config.pin_href = HREF_GPIO_NUM;
  config.pin_sscb_sda = SIOD_GPIO_NUM;
  config.pin_sscb_scl = SIOC_GPIO_NUM;
  config.pin_pwdn = PWDN_GPIO_NUM;
  config.pin_reset = RESET_GPIO_NUM;
  config.xclk_freq_hz = 24000000; // lower value for longer expoisure
  config.frame_size = FRAMESIZE_VGA;   //Fullframe: CIF, VGA, XGA, PHD, SXGA, WQXGA, QSXGA
  config.pixel_format = PIXFORMAT_JPEG;
  config.grab_mode = CAMERA_GRAB_LATEST;
  config.fb_location = CAMERA_FB_IN_PSRAM;
  config.jpeg_quality = 3;
  config.fb_count = 2;  

  esp_err_t err = esp_camera_init(&config);
    if (err != ESP_OK) {
      Serial.printf("Camera init failed with error 0x%x", err);
      return;
    }
    
  sensor_t *s = esp_camera_sensor_get();
  s->set_brightness(s, 0);     // -2 to 2
  s->set_contrast(s, 0);       // -2 to 2
  s->set_saturation(s, 0);     // -2 to 2
  s->set_special_effect(s, 0); // 0 to 6 (0 - No Effect, 1 - Negative, 2 - Grayscale, 3 - Red Tint, 4 - Green Tint, 5 - Blue Tint, 6 - Sepia)
  s->set_whitebal(s, 0);       // 0 = disable , 1 = enable
  s->set_awb_gain(s, 0);       // 0 = disable , 1 = enable
  s->set_wb_mode(s, 1);        // 0 to 4 - if awb_gain enabled (0 - Auto, 1 - Sunny, 2 - Cloudy, 3 - Office, 4 - Home)
  s->set_exposure_ctrl(s, 0);  // 0 = disable , 1 = enable
  s->set_aec2(s, 0);           // 0 = disable , 1 = enable
  s->set_ae_level(s, 0);       // -2 to 2
  s->set_aec_value(s, 0);    // 0 to 1200
  s->set_gain_ctrl(s, 0); // 0 = disable , 1 = enable
  s->set_agc_gain(s, 0);  // 0 to 30
  s->set_gainceiling(s, (gainceiling_t)0);  // 0 to 6
  s->set_bpc(s, 0);            // 0 = disable , 1 = enable
  s->set_wpc(s, 0);            // 0 = disable , 1 = enable
  s->set_raw_gma(s, 0);        // 0 = disable , 1 = enable
  s->set_lenc(s, 0);           // 0 = disable , 1 = enable
  s->set_hmirror(s, 0);        // 0 = disable , 1 = enable
  s->set_vflip(s, 0);          // 0 = disable , 1 = enable
  s->set_dcw(s, 0);            // 0 = disable , 1 = enable
  s->set_colorbar(s, 0);       // 0 = disable , 1 = enable

}

void setupOV5640_RGB565() {
  camera_config_t config;
  config.ledc_channel = LEDC_CHANNEL_0;
  config.ledc_timer = LEDC_TIMER_0;
  config.pin_d0 = Y2_GPIO_NUM;
  config.pin_d1 = Y3_GPIO_NUM;
  config.pin_d2 = Y4_GPIO_NUM;
  config.pin_d3 = Y5_GPIO_NUM;
  config.pin_d4 = Y6_GPIO_NUM;
  config.pin_d5 = Y7_GPIO_NUM;
  config.pin_d6 = Y8_GPIO_NUM;
  config.pin_d7 = Y9_GPIO_NUM;
  config.pin_xclk = XCLK_GPIO_NUM;
  config.pin_pclk = PCLK_GPIO_NUM;
  config.pin_vsync = VSYNC_GPIO_NUM;
  config.pin_href = HREF_GPIO_NUM;
  config.pin_sscb_sda = SIOD_GPIO_NUM;
  config.pin_sscb_scl = SIOC_GPIO_NUM;
  config.pin_pwdn = PWDN_GPIO_NUM;
  config.pin_reset = RESET_GPIO_NUM;
  config.xclk_freq_hz = 20000000; // 20 MHz
  config.frame_size = FRAMESIZE_320X320; // Fullframe: CIF, VGA, XGA, HD, PHD, SXGA, WQXGA
  config.pixel_format = PIXFORMAT_RGB565; // Set to RGB565 format
  config.grab_mode = CAMERA_GRAB_LATEST;
  config.fb_location = CAMERA_FB_IN_PSRAM;
  config.jpeg_quality = 12;
  config.fb_count = 2;  

  esp_err_t err = esp_camera_init(&config);
    if (err != ESP_OK) {
      Serial.printf("Camera init failed with error 0x%x", err);
      return;
    }
    
  sensor_t *s = esp_camera_sensor_get();
  s->set_brightness(s, 0);     // -2 to 2
  s->set_contrast(s, 0);       // -2 to 2
  s->set_saturation(s, 0);     // -2 to 2
  s->set_special_effect(s, 0); // 0 to 6 (0 - No Effect, 1 - Negative, 2 - Grayscale, 3 - Red Tint, 4 - Green Tint, 5 - Blue Tint, 6 - Sepia)
  s->set_whitebal(s, 0);       // 0 = disable , 1 = enable
  s->set_awb_gain(s, 0);       // 0 = disable , 1 = enable
  s->set_wb_mode(s, 1);        // 0 to 4 - if awb_gain enabled (0 - Auto, 1 - Sunny, 2 - Cloudy, 3 - Office, 4 - Home)
  s->set_exposure_ctrl(s, 0);  // 0 = disable , 1 = enable
  s->set_aec2(s, 0);           // 0 = disable , 1 = enable
  s->set_ae_level(s, 0);       // -2 to 2
  s->set_aec_value(s, 0);    // 0 to 1200
  s->set_gain_ctrl(s, 0); // 0 = disable , 1 = enable
  s->set_agc_gain(s, 6);  // 0 to 30

//  delay(100);
//  s->set_gain_ctrl(s, 0);
//  s->set_agc_gain(s, 0);

  s->set_gainceiling(s, (gainceiling_t)0);  // 0 to 6
  s->set_bpc(s, 0);            // 0 = disable , 1 = enable
  s->set_wpc(s, 0);            // 0 = disable , 1 = enable
  s->set_raw_gma(s, 0);        // 0 = disable , 1 = enable 
  s->set_lenc(s, 0);           // 0 = disable , 1 = enable
  s->set_hmirror(s, 0);        // 0 = disable , 1 = enable
  s->set_vflip(s, 0);          // 0 = disable , 1 = enable
  s->set_dcw(s, 0);            // 0 = disable , 1 = enable
  s->set_colorbar(s, 0);       // 0 = disable , 1 = enable
}

void setupTSL2591() {
    if (!tsl.begin()) {
        Serial.println("TSL2591 initialize error.");
        while (1);
    }
    tsl.Enable();
    updateGain('I', I_gainValue);
    updateIntegrationTime('I', I_integrationTime);
}

void setupAS7331() {
    if (!as7331.begin()) {
        Serial.println("AS7331 initialize error.");
        while (1);
    }
    as7331.Set_Device_State(AS7331_STATE_CONFIGURATION);
    as7331.Set_Mode(AS7331_MMODE_CONT);
    as7331.Set_CCLK(AS7331_CCLK_1024);
    updateGain('U', U_gainValue);
    updateIntegrationTime('U', U_integrationTime);
    as7331.Set_BREAK(25);
    as7331.Set_Device_State(AS7331_STATE_MEASUREMENT);
    as7331.Set_Measurement(AS7331_MEASUREMENT_START);
}

void setupAS7265X() {
  if (!as7265x.begin()) {
      Serial.println("AS7265X initialize error.");
      while (1);
  as7265x.Set_Interrupt(true);
  as7265x.Set_Measurement(AS7265X_MEASUREMENT_MODE2);
  updateGain('S', S_gainValue);
  updateIntegrationTime('S', S_integrationTime);
  }
}

void setupSHT4X() {
  if (!sht.begin()) {
    Serial.println("Not found the SHT4X");
    while (1);
  }
}
